leoogrizek/Transmitter/(commit log)

2023-05-08 added register and spi command macros
2023-05-09 added basic uart functionality
2023-05-15 antenna works
2023-05-19 fully functional servo + bldc control
